SunshadeCorp/GPIO-Adapter/documentation/12v-power-supply.png

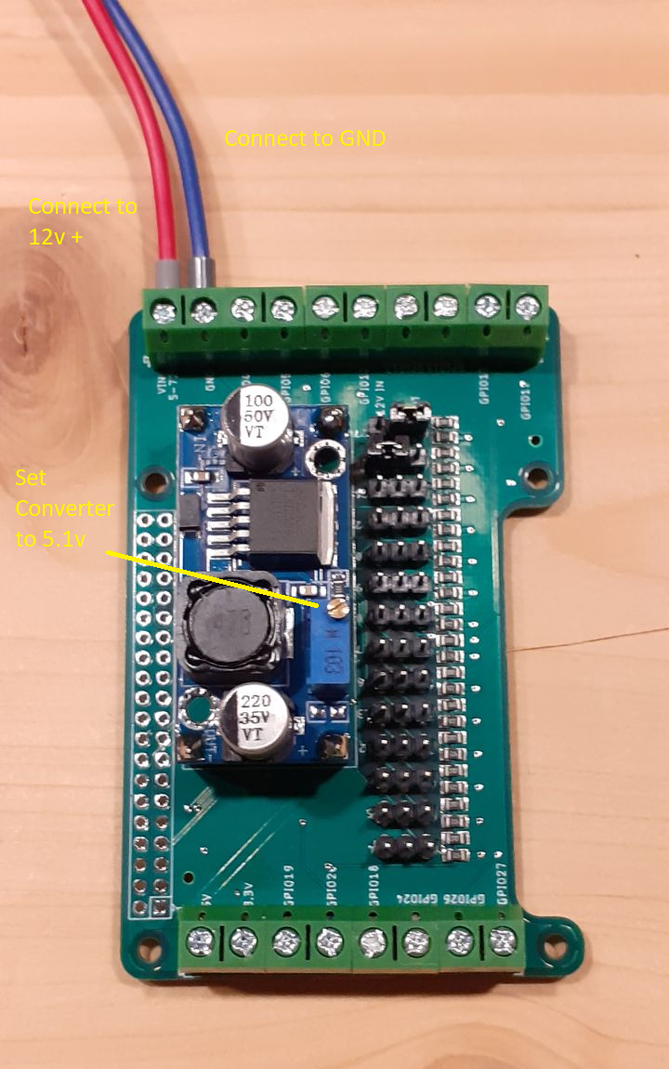
documentation/12v-power-supply.png
