SunshadeCorp/GPIO-Adapter/documentation/gpio-labeled.png

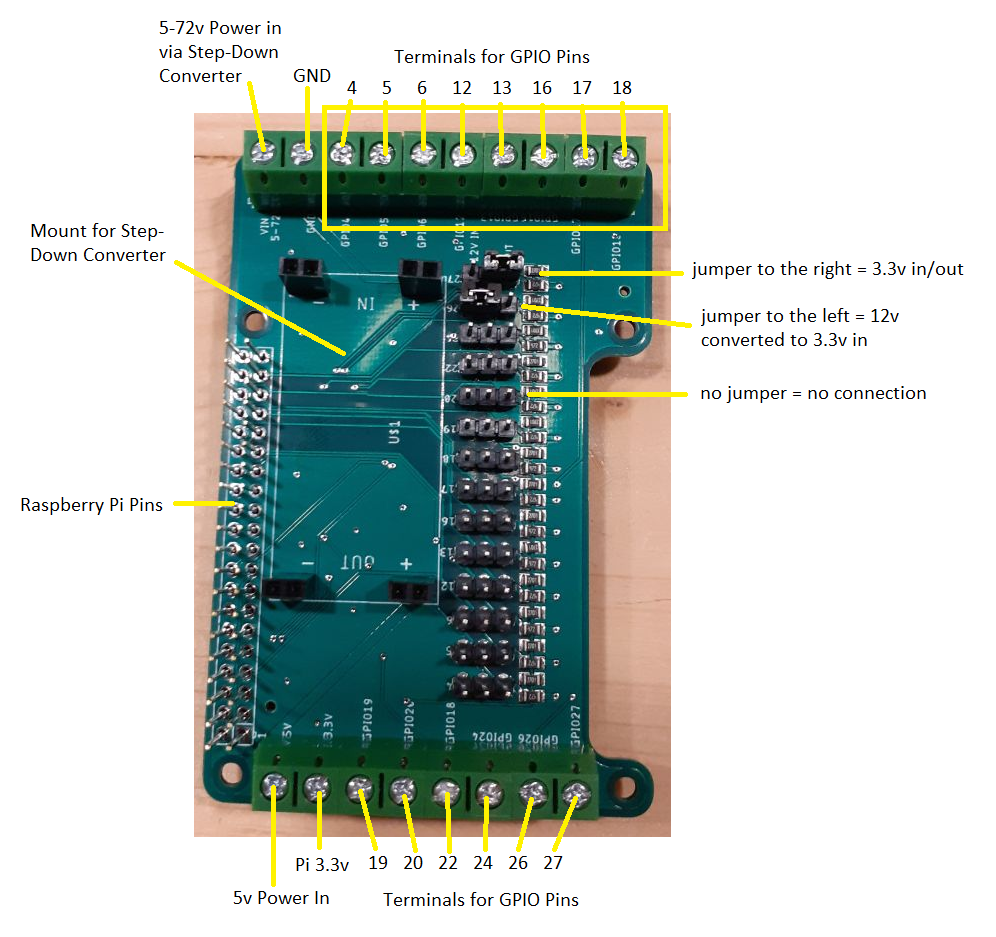
documentation/gpio-labeled.png
