SunshadeCorp/GPIO-Adapter/README.md

# Raspberry Pi GPIO-Adapter HAT
GPIO-Adapter as RPi HAT for powering the Pi and connecting EconomizerLT units to drive high current relias
