SunshadeCorp/GPIO-Adapter/documentation/5v-power-supply.png

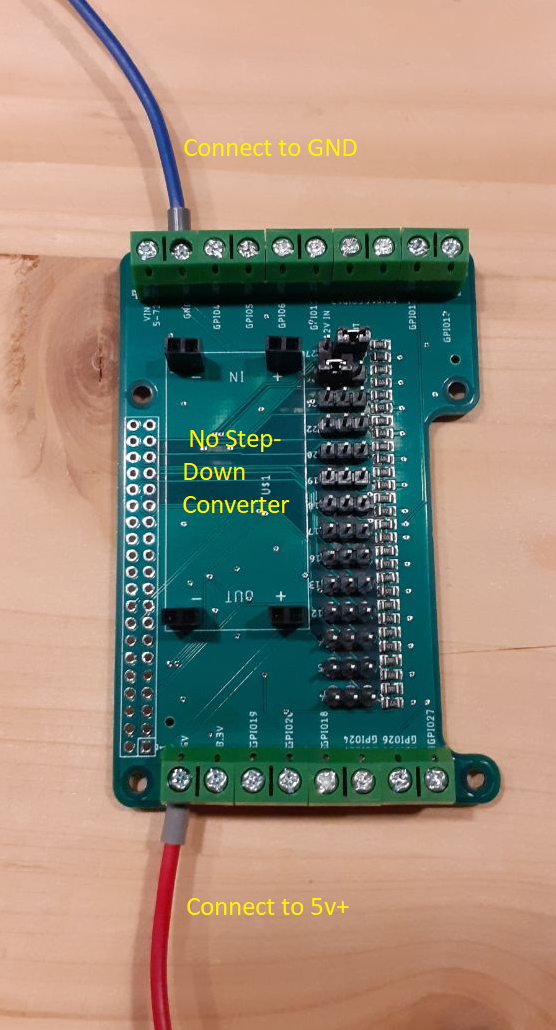
documentation/5v-power-supply.png
