SunshadeCorp/GPIO-Adapter/GPIO_Adapter_top_bom.csv

Comment | Designator | Footprint | LCSC Part #
2k7 | R2 R6 R8 R10 R12 R14 R16 R18 R20 R22 R24 R26 R28 R30 | R0805
7k5 | R1 R5 R7 R9 R11 R13 R15 R17 R19 R21 R23 R25 R27 R29 | R0805
