SunshadeCorp/GPIO-Adapter/GPIO_Adapter.brd

## EAGLE design GPIO_Adapter.brd (2022-01-24)

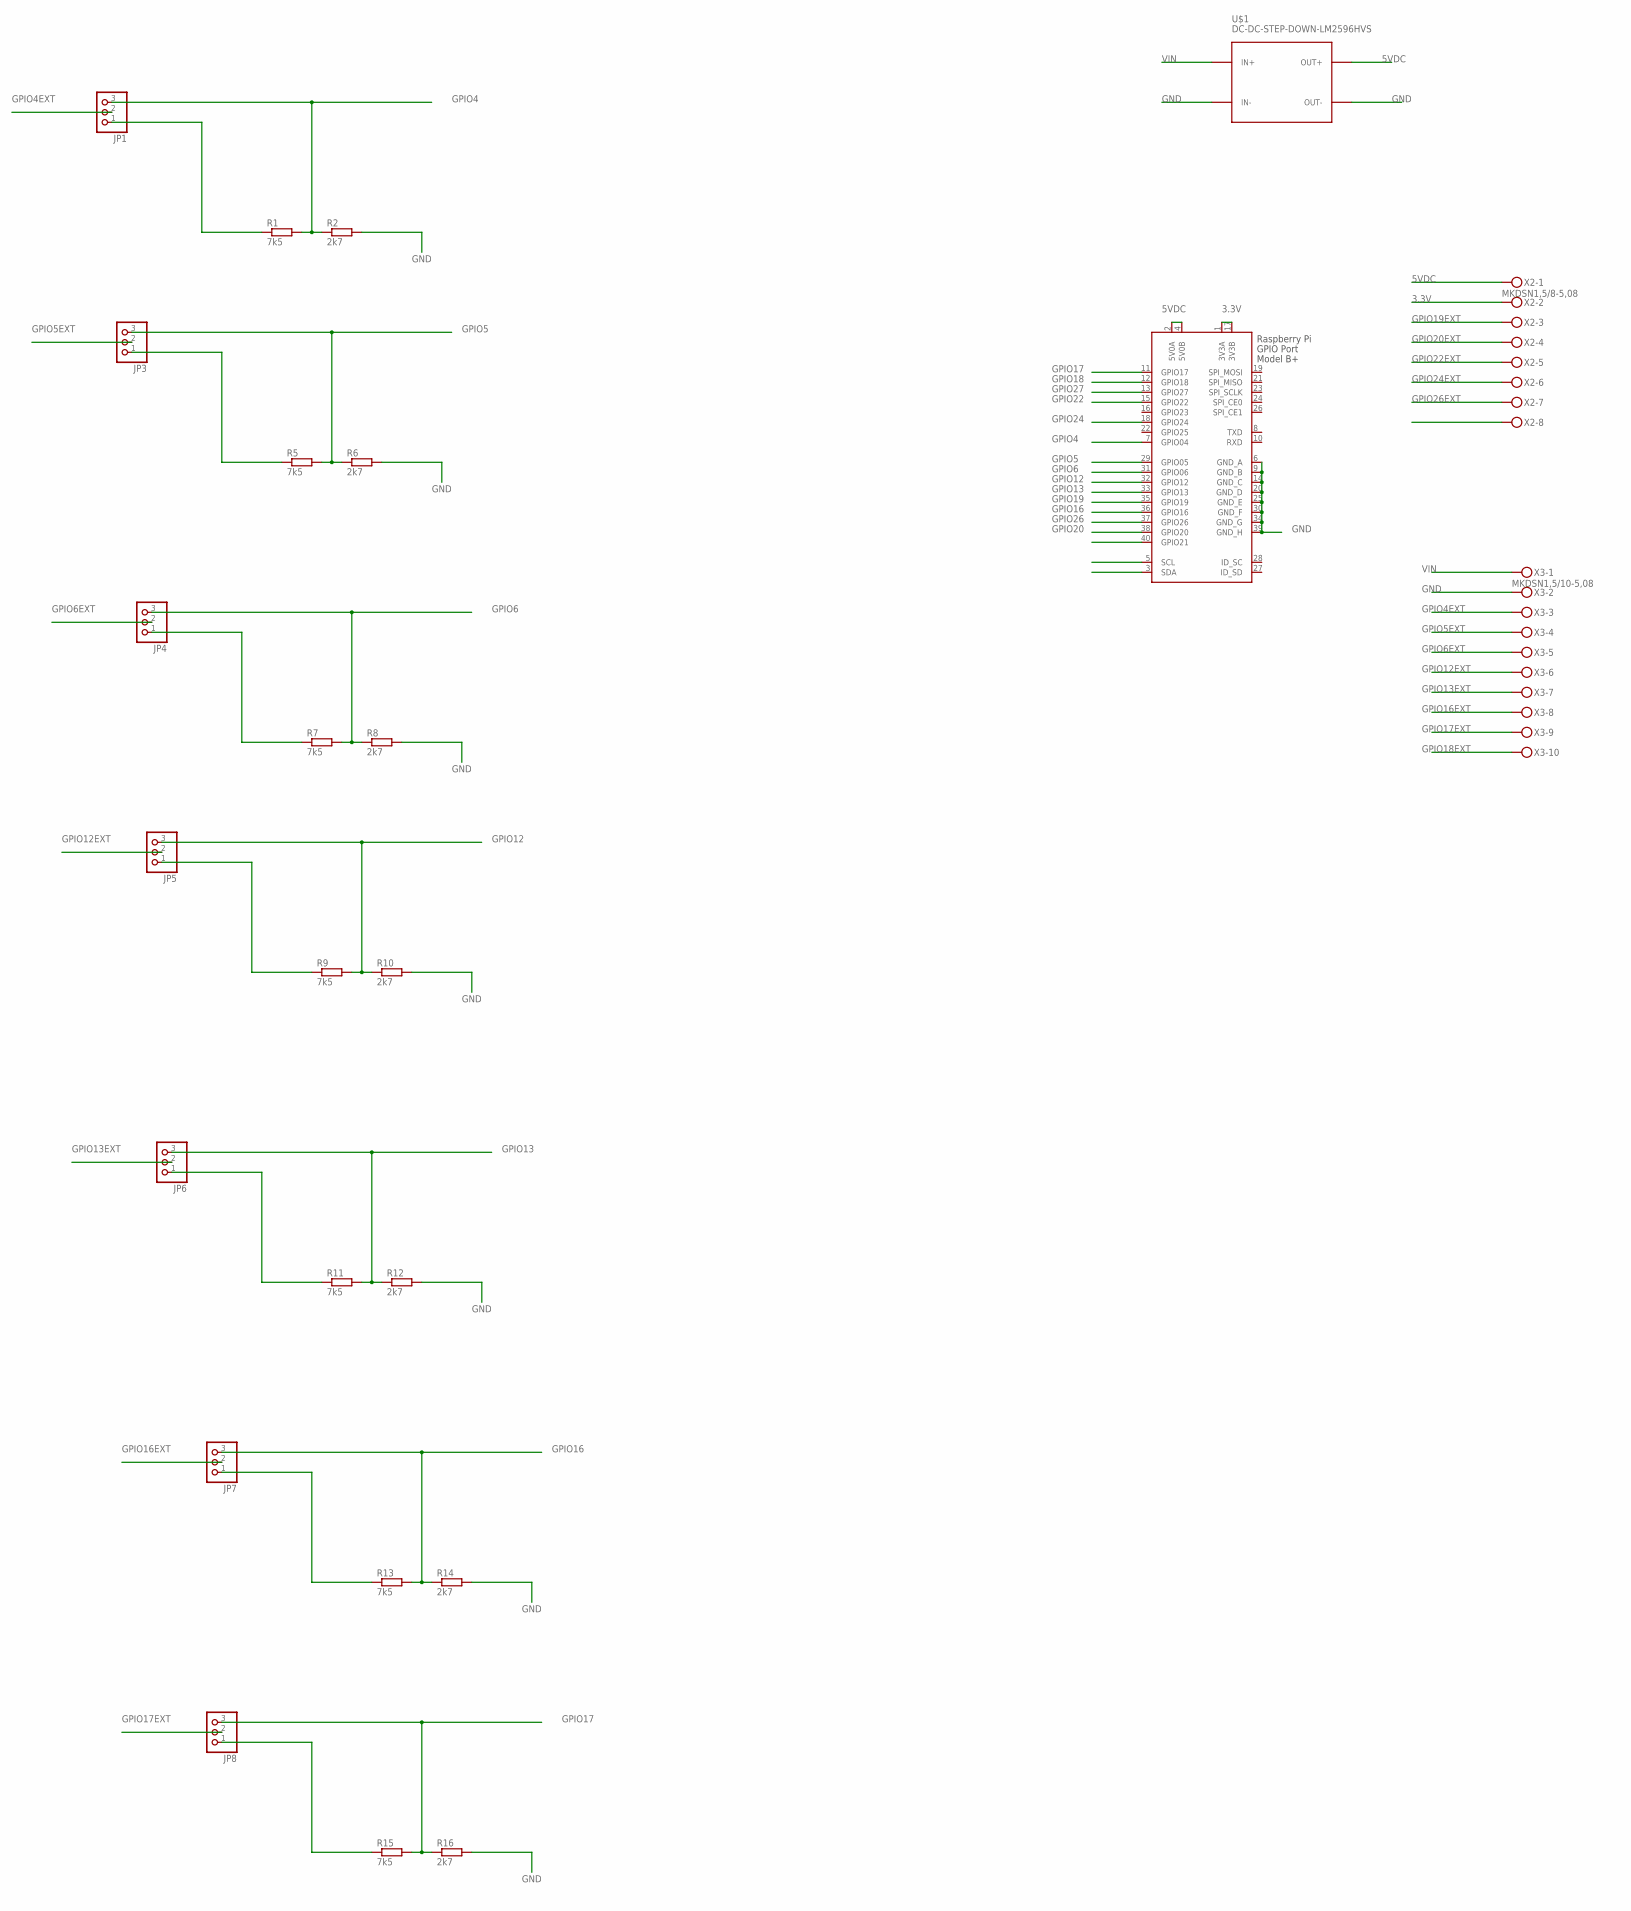
[picture p4: schematic GPIO_Adapter.sch, part in row 1, column 1]

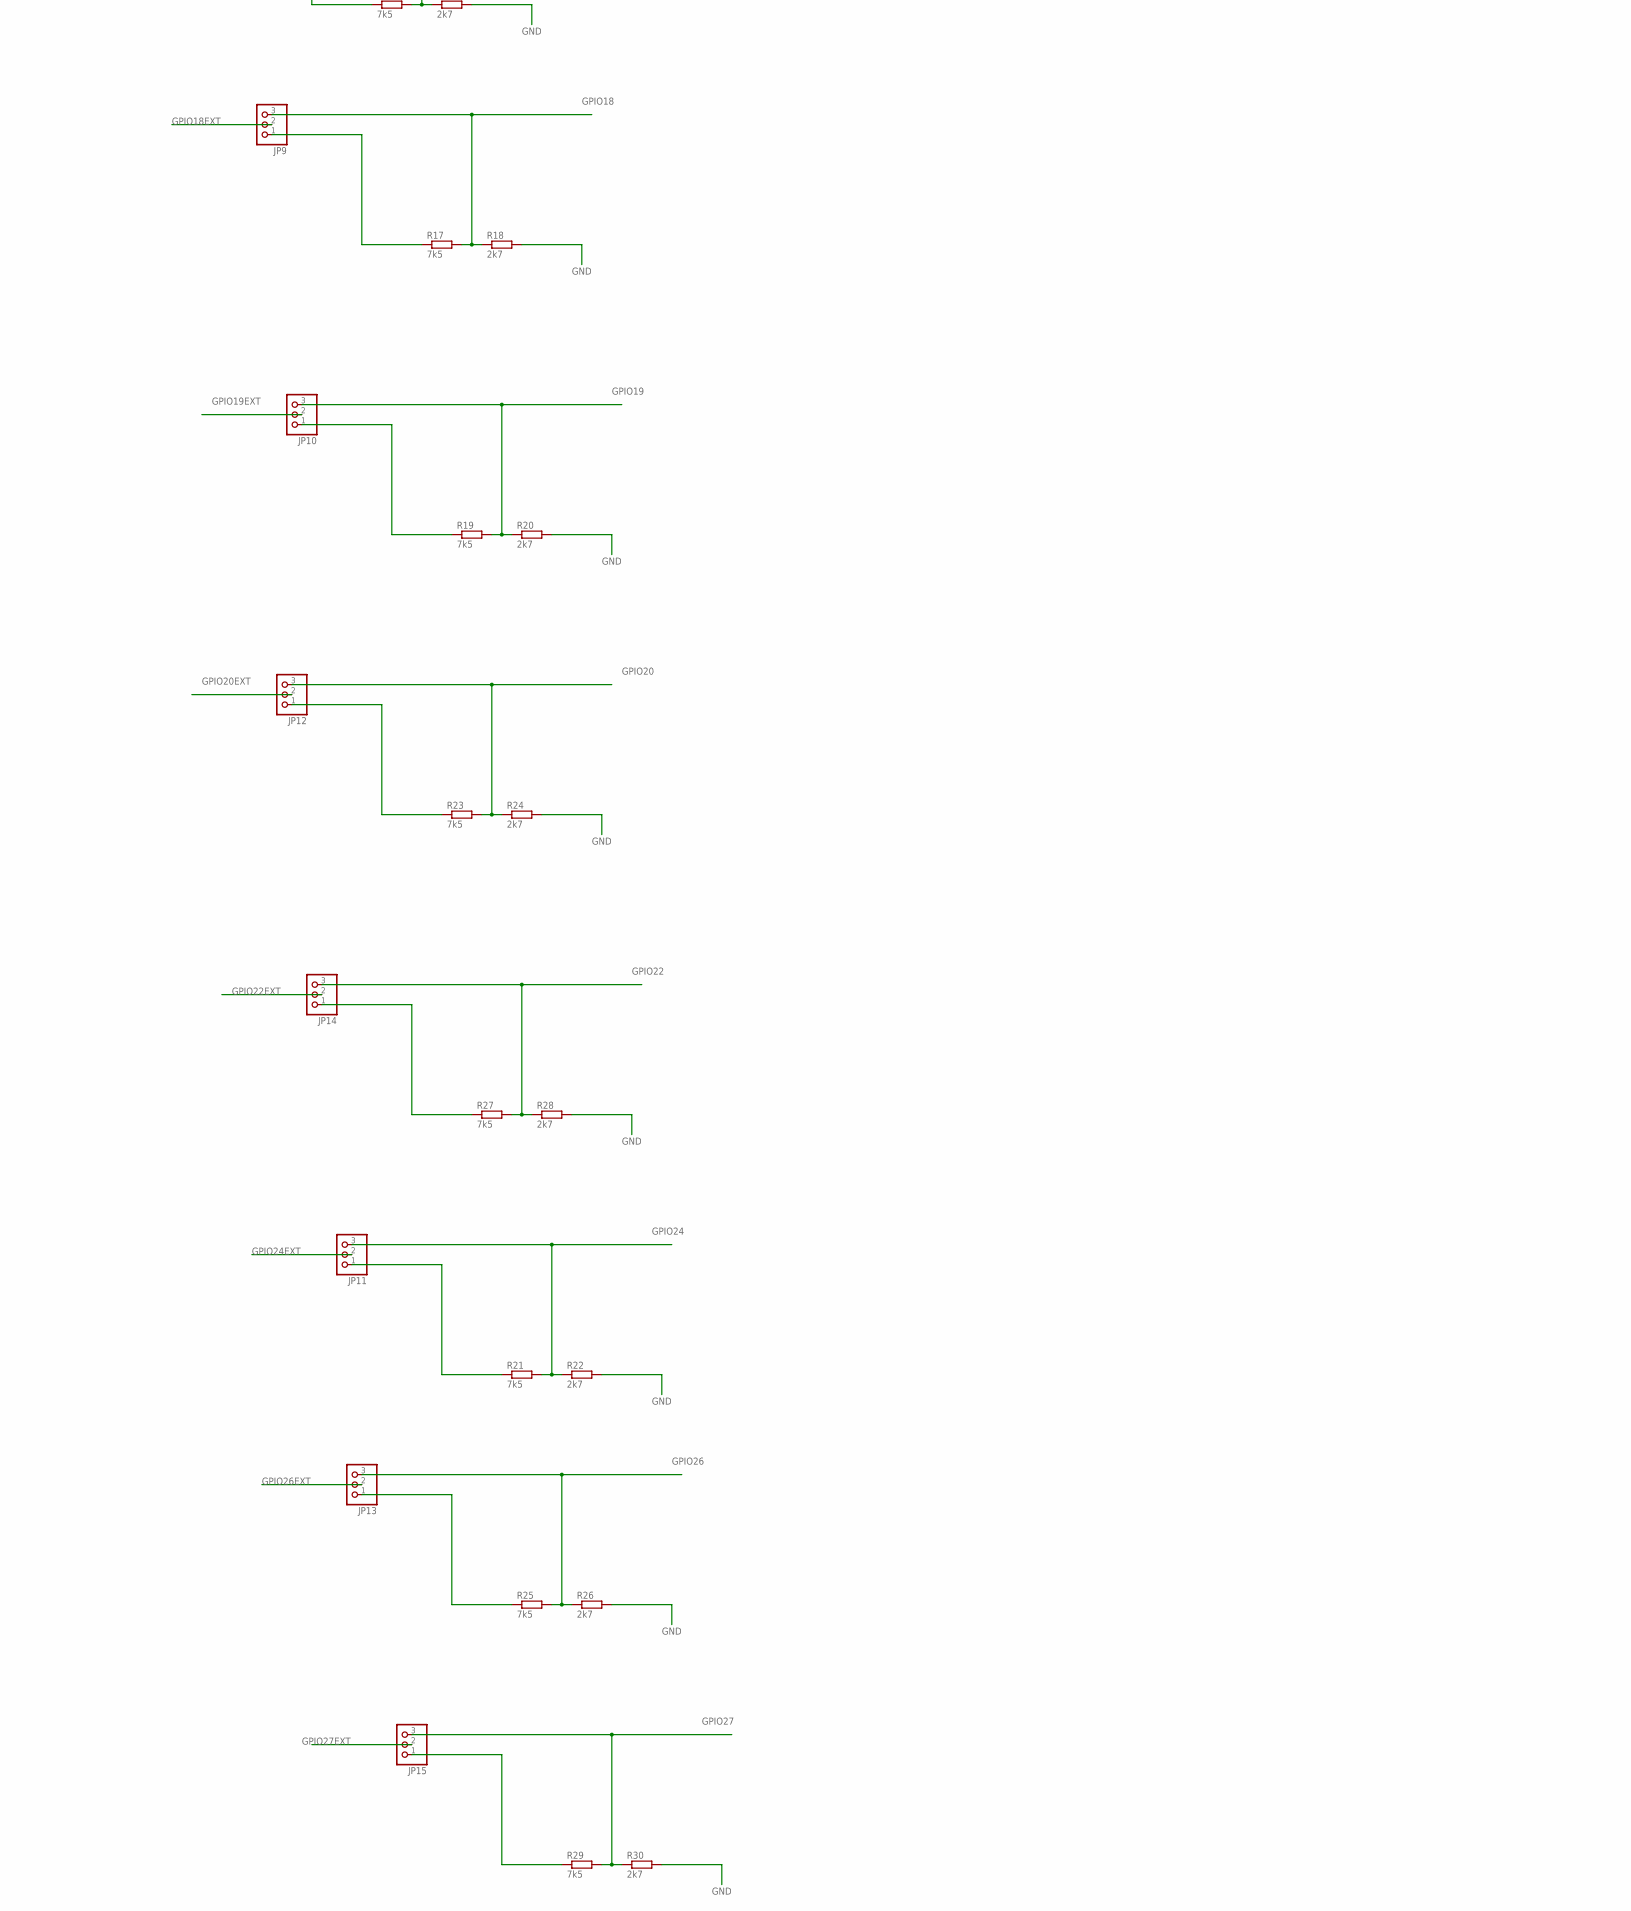
[picture p5: schematic GPIO_Adapter.sch, part in row 2, column 1]

Parts:
JP1, JP3, JP4, JP5, JP6, JP7, JP8, JP9, JP10, JP11, JP12, JP13, JP14, JP15: PINHD-1X3; 1X03
R1, R5, R7, R9, R11, R13, R15, R17, R19, R21, R23, R25, R27, R29: 7k5; R0805
R2, R6, R8, R10, R12, R14, R16, R18, R20, R22, R24, R26, R28, R30: 2k7; R0805
U$1: DC-DC-STEP-DOWN-LM2596HVS
X1: RASPI_BOARD_B+#_F; RASPI_BOARD_B+_FULL
X2: MKDSN1,5/8-5,08
X3: MKDSN1,5/10-5,08

Connections:
3.3V: X1.1 (3V3A), X1.17 (3V3B), X2.2
5VDC: U$1.OUT+, X1.2 (5V0A), X1.4 (5V0B), X2.1
GND: R2.2, R6.2, R8.2, R10.2, R12.2, R14.2, R16.2, R18.2, R20.2, R22.2, R24.2, R26.2, R28.2, R30.2, U$1.IN-, U$1.OUT-, X1.6 (GND_A), X1.9 (GND_B), X1.14 (GND_C), X1.20 (GND_D), X1.25 (GND_E), X1.30 (GND_F), X1.34 (GND_G), X1.39 (GND_H), X3.2
GPIO4: JP1.3, R1.2, R2.1, X1.7 (GPIO04)
GPIO4EXT: JP1.2, X3.3
GPIO5: JP3.3, R5.2, R6.1, X1.29 (GPIO05)
GPIO5EXT: JP3.2, X3.4
GPIO6: JP4.3, R7.2, R8.1, X1.31 (GPIO06)
GPIO6EXT: JP4.2, X3.5
GPIO12: JP5.3, R9.2, R10.1, X1.32 (GPIO12)
GPIO12EXT: JP5.2, X3.6
GPIO13: JP6.3, R11.2, R12.1, X1.33 (GPIO13)
GPIO13EXT: JP6.2, X3.7
GPIO16: JP7.3, R13.2, R14.1, X1.36 (GPIO16)
GPIO16EXT: JP7.2, X3.8
GPIO17: JP8.3, R15.2, R16.1, X1.11 (GPIO17)
GPIO17EXT: JP8.2, X3.9
GPIO18: JP9.3, R17.2, R18.1, X1.12 (GPIO18)
GPIO18EXT: JP9.2, X3.10
GPIO19: JP10.3, R19.2, R20.1, X1.35 (GPIO19)
GPIO19EXT: JP10.2, X2.3
GPIO20: JP12.3, R23.2, R24.1, X1.38 (GPIO20)
GPIO20EXT: JP12.2, X2.4
GPIO22: JP14.3, R27.2, R28.1, X1.15 (GPIO22)
GPIO22EXT: JP14.2, X2.5
GPIO24: JP11.3, R21.2, R22.1, X1.18 (GPIO24)
GPIO24EXT: JP11.2, X2.6
GPIO26: JP13.3, R25.2, R26.1, X1.37 (GPIO26)
GPIO26EXT: JP13.2, X2.7
GPIO27: JP15.3, R29.2, R30.1, X1.13 (GPIO27)
GPIO27EXT: JP15.2, X2.8
unnamed: JP1.1, R1.1
unnamed: JP3.1, R5.1
unnamed: JP4.1, R7.1
unnamed: JP5.1, R9.1
unnamed: JP6.1, R11.1
unnamed: JP7.1, R13.1
unnamed: JP8.1, R15.1
unnamed: JP9.1, R17.1
unnamed: JP10.1, R19.1
unnamed: JP11.1, R21.1
unnamed: JP12.1, R23.1
unnamed: JP13.1, R25.1
unnamed: JP14.1, R27.1
unnamed: JP15.1, R29.1
VIN: U$1.IN+, X3.1

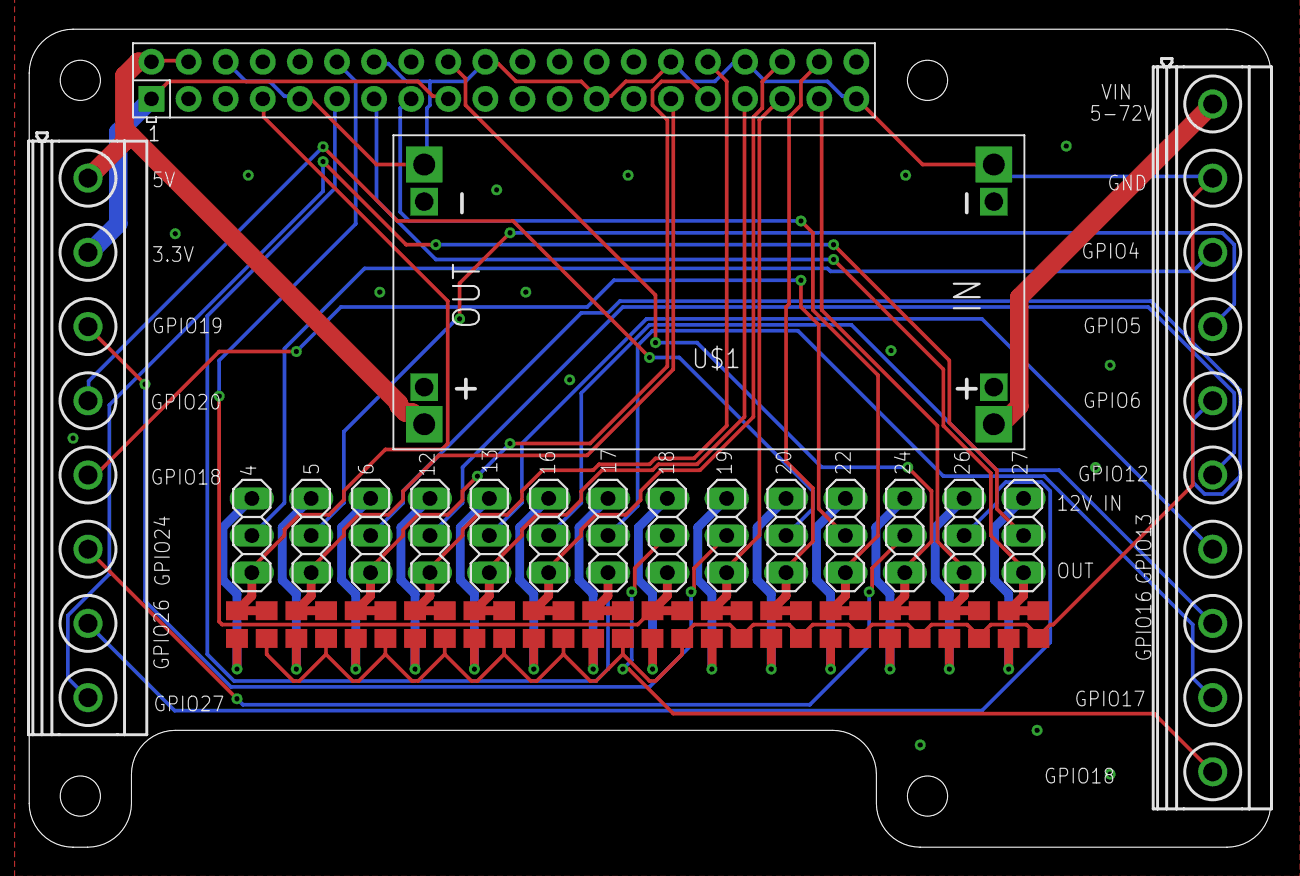
[picture p6: board GPIO_Adapter.brd from above]

Board: 2 copper layers, 85.0 x 56.0 mm, 46 parts (0 on the bottom side), 46 nets.
