SunshadeCorp/GPIO-Adapter/(commit log)

2021-12-03 Initial commit, files copied from EasyBMS_Hardware repo
    [GPIO_Adapter.brd, GPIO_Adapter.sch]
2022-01-24 comment added on board, gerber files created
    [GPIO_Adapter.brd, GPIO_Adapter_top_bom.csv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]
